mquerostudio/OpenNAS/1-CAD/HDD_Panel.FCStd

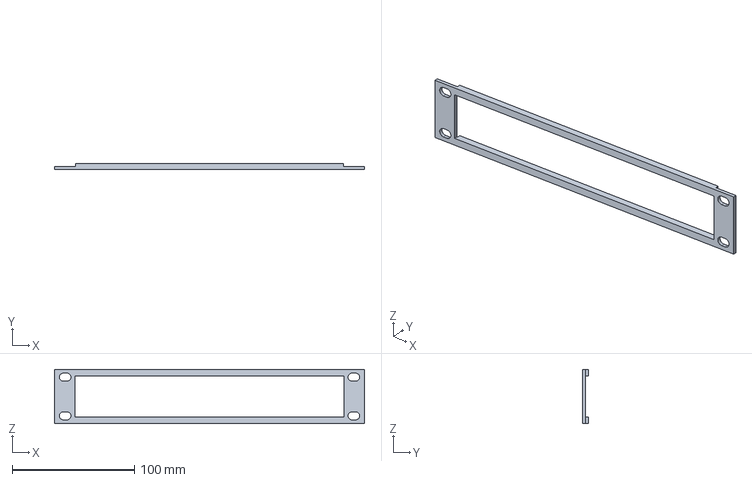
[picture p1: CAD file, 2026-03-18]
1-CAD/HDD_Panel.FCStd
254.0 x 5.00 x 44.2 mm
