mquerostudio/OpenNAS/1-CAD/Modular 10 Server/Base/Feet Right.step

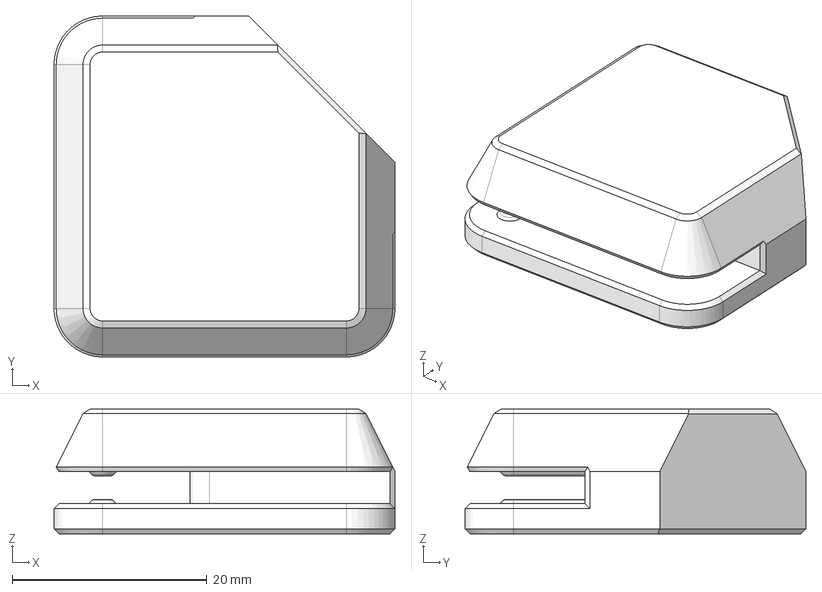
[picture p2: CAD file, 2025-12-29]
1-CAD/Modular 10 Server/Base/Feet Right.step
35.0 x 35.0 x 12.8 mm
