mquerostudio/OpenNAS/1-CAD/Modular 10 Server/Cover/Cover Plate Holes.step

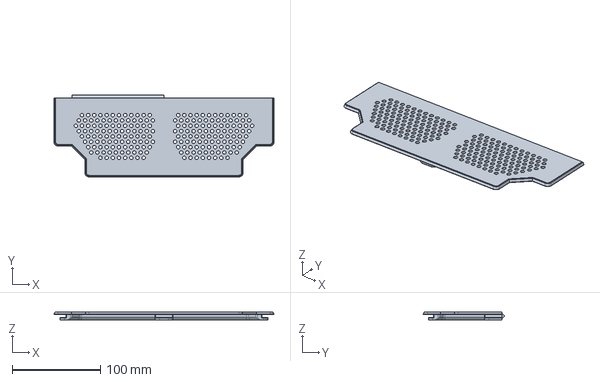
[picture p3: CAD file, 2025-12-29]
1-CAD/Modular 10 Server/Cover/Cover Plate Holes.step
249.6 x 92.8 x 9.60 mm
