mquerostudio/OpenNAS/1-CAD/Modular 10 Server/Panels/Panels.FCStd

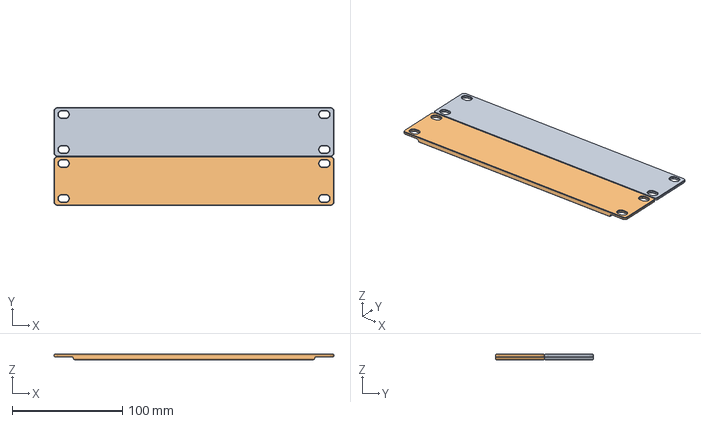
[picture p4: CAD file, 2025-12-29]
1-CAD/Modular 10 Server/Panels/Panels.FCStd
254.0 x 88.7 x 5.00 mm
Panel002
Panel001
