mquerostudio/OpenNAS/1-CAD/Modular 10 Server/Shelfs/Shelf 100mm 1U.step

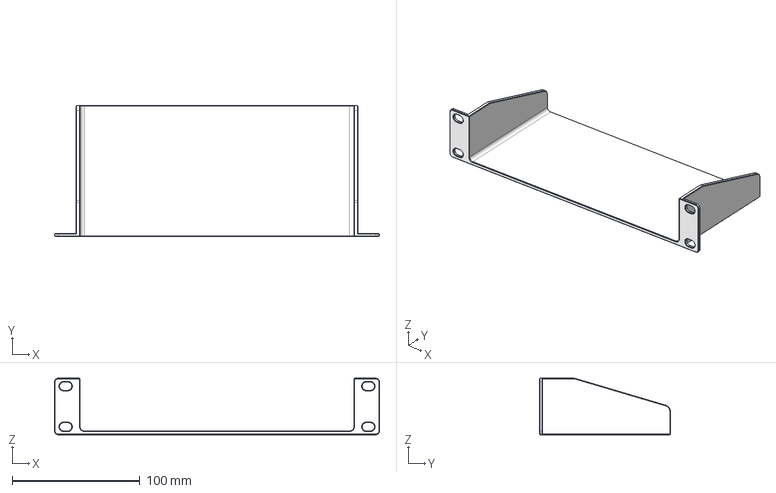
[picture p5: CAD file, 2025-12-29]
1-CAD/Modular 10 Server/Shelfs/Shelf 100mm 1U.step
254.0 x 102.5 x 44.2 mm
