mquerostudio/OpenNAS/1-CAD/Caddy.FCStd

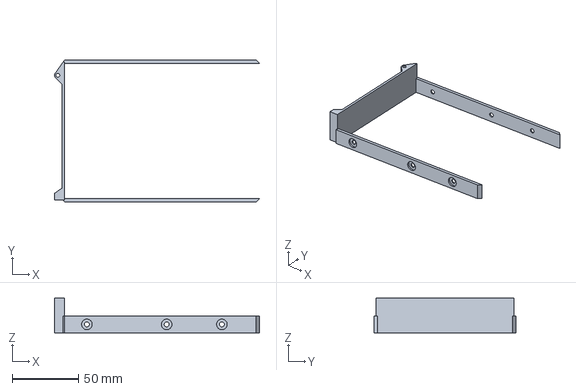
[picture p6: CAD file, 2026-03-18]
1-CAD/Caddy.FCStd
154.3 x 106.8 x 26.1 mm
