mquerostudio/OpenNAS/1-CAD/Modular 10 Server/Cover/Cover Plate Plain.step

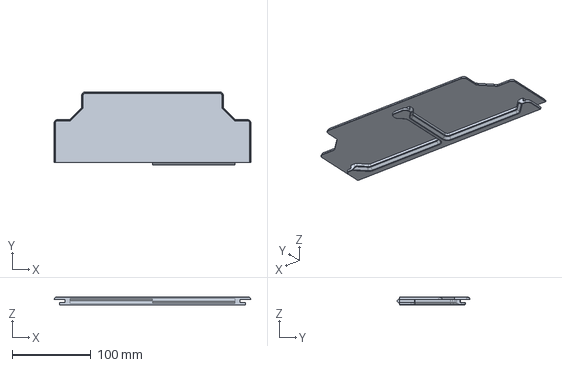
[picture p7: CAD file, 2025-12-29]
1-CAD/Modular 10 Server/Cover/Cover Plate Plain.step
249.6 x 92.8 x 9.60 mm
