mquerostudio/OpenNAS/1-CAD/Modular 10 Server/Panels/Panel 2U.step

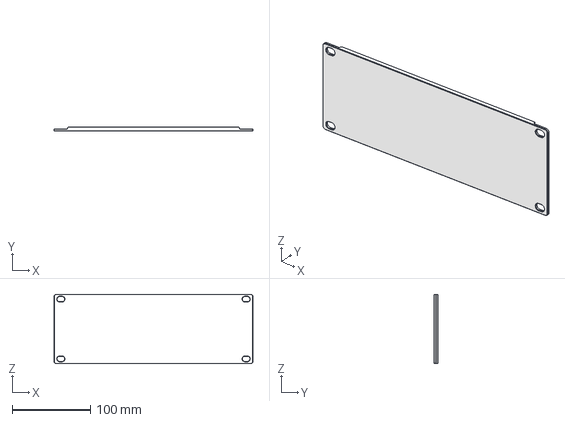
[picture p8: CAD file, 2025-12-29]
1-CAD/Modular 10 Server/Panels/Panel 2U.step
254.0 x 5.00 x 88.7 mm
