mquerostudio/OpenNAS/1-CAD/Modular 10 Server/Shelfs/Shelf 100mm 2U.step

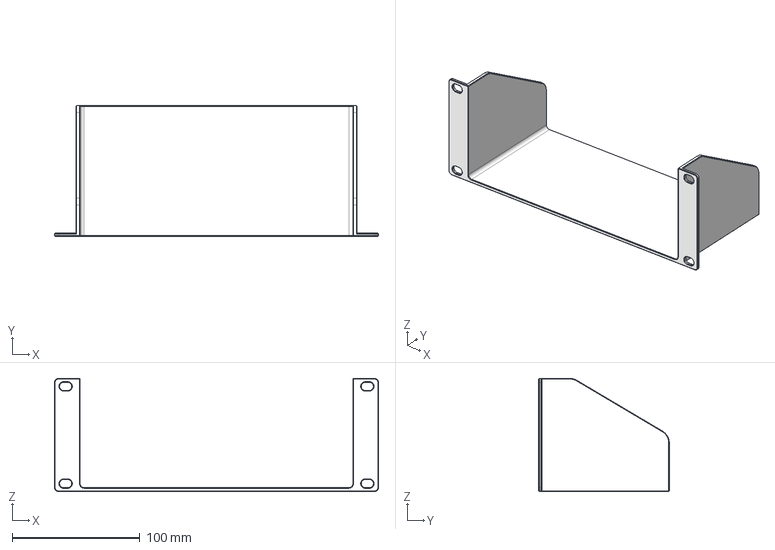
[picture p9: CAD file, 2025-12-29]
1-CAD/Modular 10 Server/Shelfs/Shelf 100mm 2U.step
254.0 x 102.5 x 88.7 mm
