mquerostudio/OpenNAS/1-CAD/Modular 10 Server/Base/Bracket Left.step

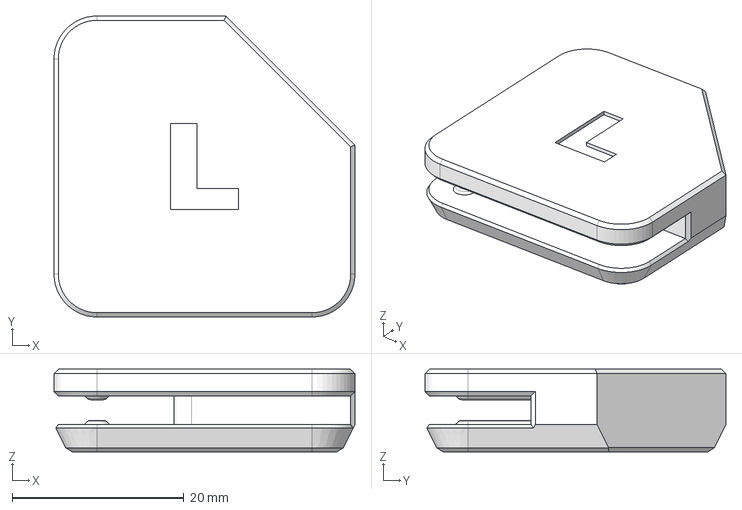
[picture p10: CAD file, 2025-12-29]
1-CAD/Modular 10 Server/Base/Bracket Left.step
35.0 x 35.0 x 9.60 mm
