mquerostudio/OpenNAS/1-CAD/Modular 10 Server/Panels/Panel 1U.step

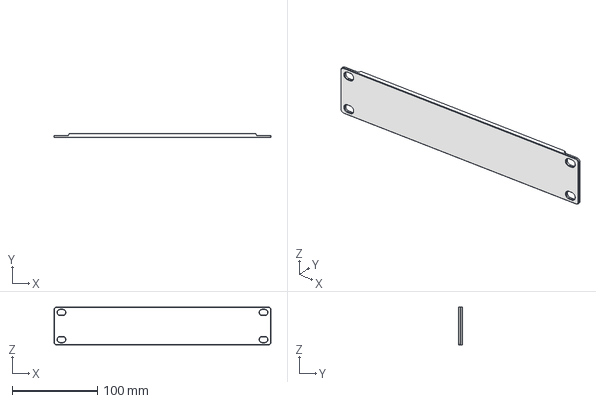
[picture p11: CAD file, 2025-12-29]
1-CAD/Modular 10 Server/Panels/Panel 1U.step
254.0 x 5.00 x 44.3 mm
