mquerostudio/OpenNAS/1-CAD/NAS_Panel-NASBody.stl

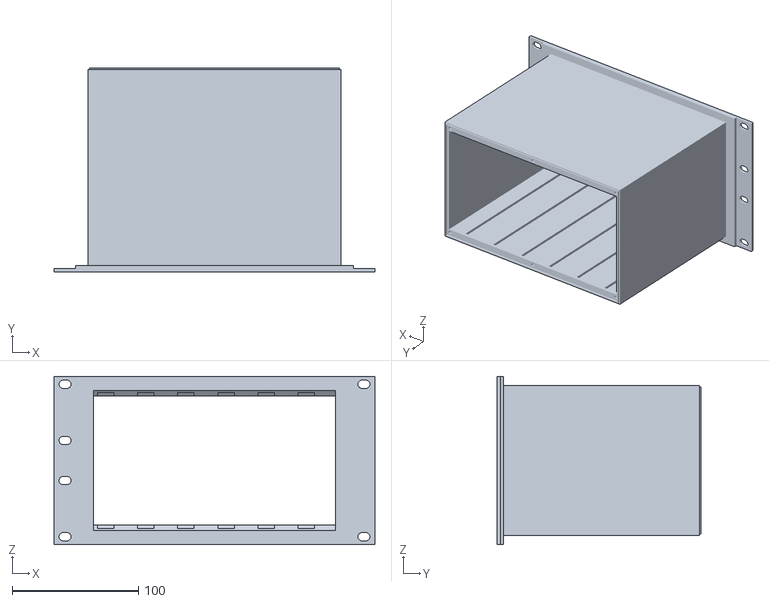
[picture p12: CAD file, 2026-03-18]
1-CAD/NAS_Panel-NASBody.stl
254.0 x 161.2 x 133.1
