mquerostudio/OpenNAS/1-CAD/Modular 10 Server/Base/Cross Panel.step

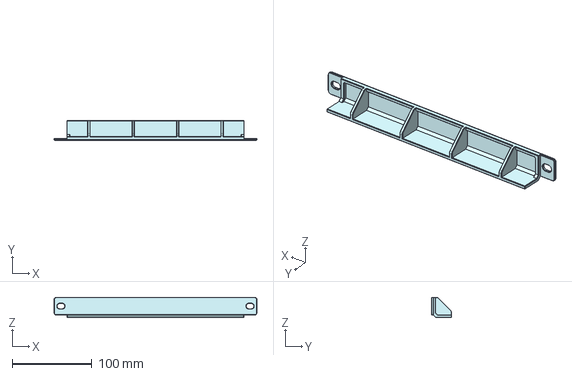
[picture p13: CAD file, 2025-12-29]
1-CAD/Modular 10 Server/Base/Cross Panel.step
254.0 x 24.7 x 25.3 mm
