mquerostudio/OpenNAS/1-CAD/Server.FCStd

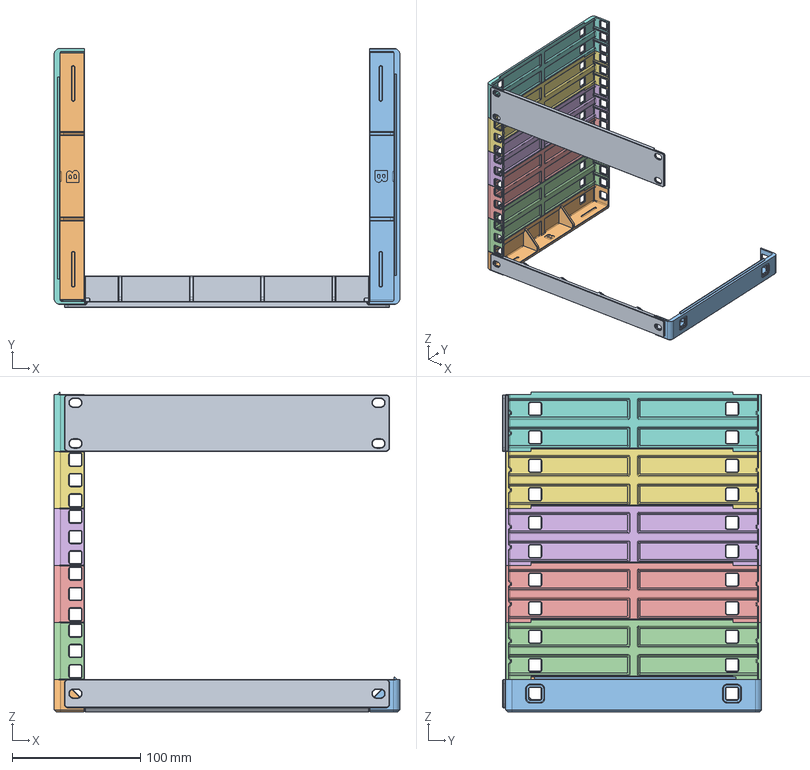
[picture p14: CAD file, 2026-03-18]
1-CAD/Server.FCStd
270.0 x 202.5 x 249.7 mm
Cross Panel
BottomL
BottomR
SideL1
SideL2
SideL3
SideL4
SideL5
Panel
