mquerostudio/OpenNAS/1-CAD/Modular 10 Server/Base/Side 1U.step

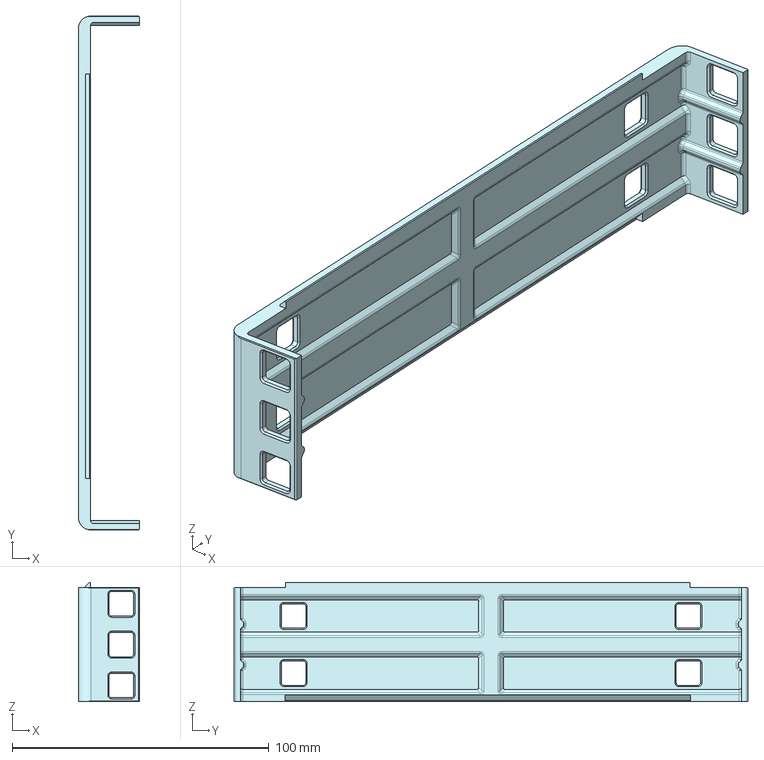
[picture p15: CAD file, 2025-12-29]
1-CAD/Modular 10 Server/Base/Side 1U.step
23.9 x 200.0 x 46.5 mm
