mquerostudio/OpenNAS/1-CAD/NAS_Panel-NASSketch009.dxf

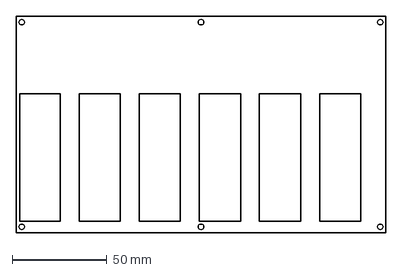
[picture p16: CAD file, 2026-03-18]
1-CAD/NAS_Panel-NASSketch009.dxf
195.5 x 114.3 mm
