mquerostudio/OpenNAS/1-CAD/Modular 10 Server/Base/Connector Cross Panel.step

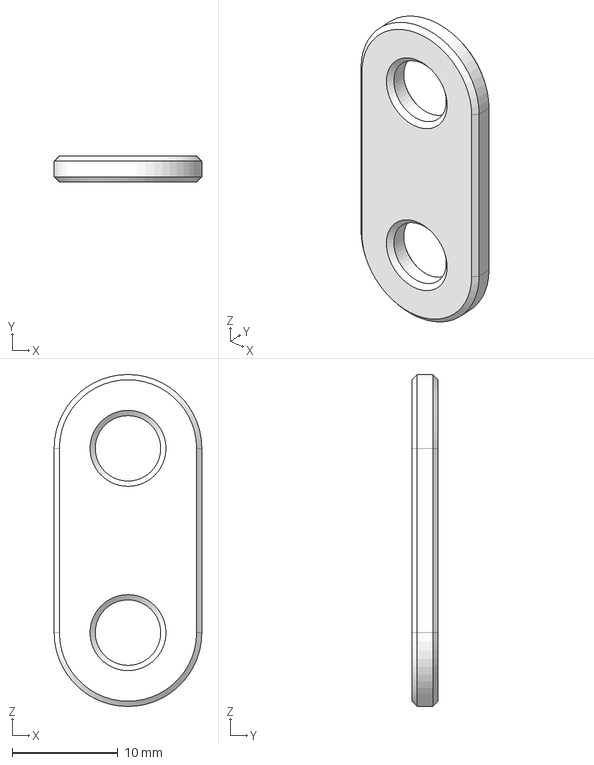
[picture p17: CAD file, 2025-12-29]
1-CAD/Modular 10 Server/Base/Connector Cross Panel.step
14.0 x 2.50 x 31.5 mm
