mquerostudio/OpenNAS/1-CAD/NAS_Panel-NASPCBA.dxf

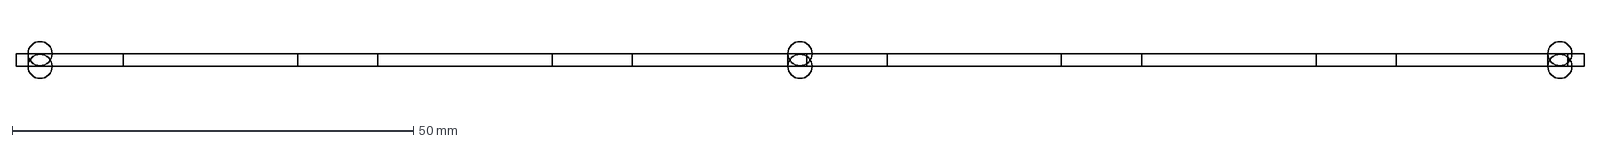
[picture p18: CAD file, 2026-03-18]
1-CAD/NAS_Panel-NASPCBA.dxf
195.5 x 4.60 mm
