mquerostudio/OpenNAS/1-CAD/Caddy-CaddyLid.stl

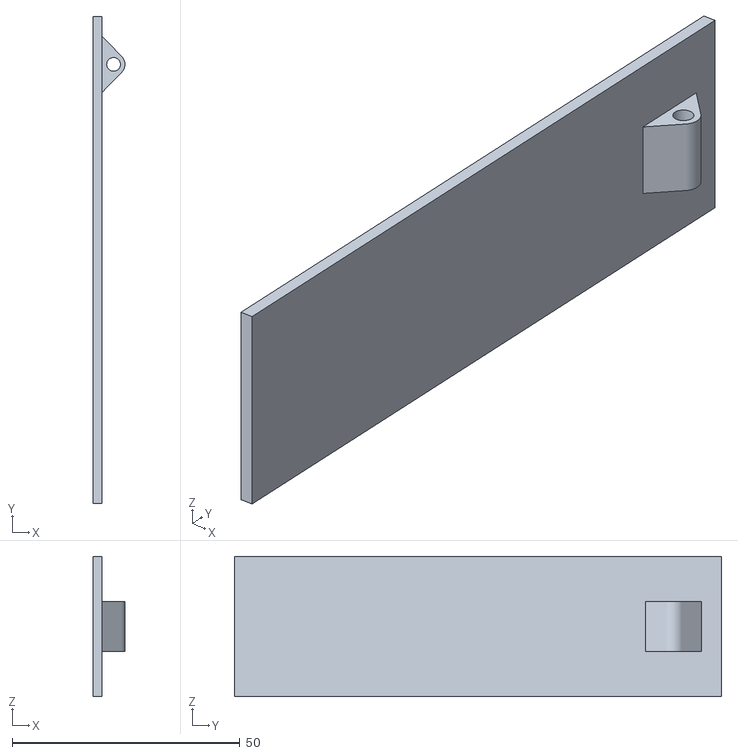
[picture p19: CAD file, 2026-03-18]
1-CAD/Caddy-CaddyLid.stl
7.00 x 106.8 x 30.8
