mquerostudio/OpenNAS/1-CAD/Modular 10 Server/Base/Connector Panel.step

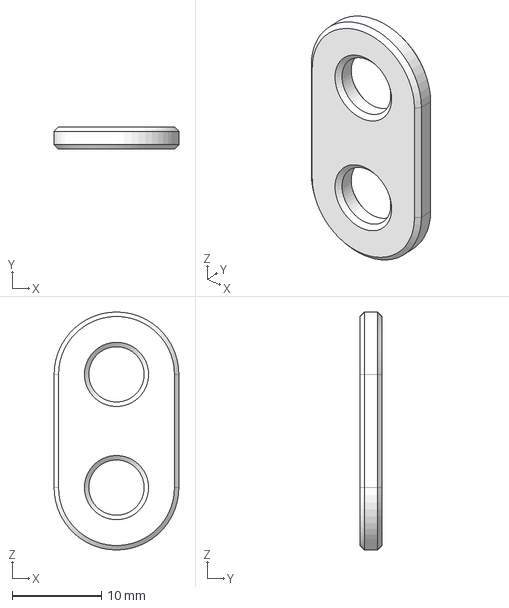
[picture p20: CAD file, 2025-12-29]
1-CAD/Modular 10 Server/Base/Connector Panel.step
14.0 x 2.50 x 26.7 mm
