mquerostudio/OpenNAS/1-CAD/HDD_IronWolf.FCStd

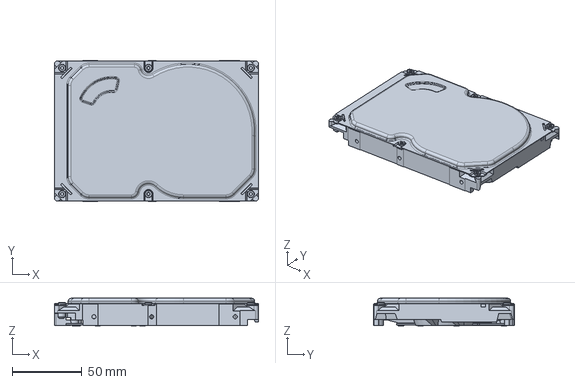
[picture p21: CAD file, 2026-03-18]
1-CAD/HDD_IronWolf.FCStd
146.5 x 101.5 x 19.8 mm
