mquerostudio/OpenNAS/1-CAD/Modular 10 Server/Base/Connector.step

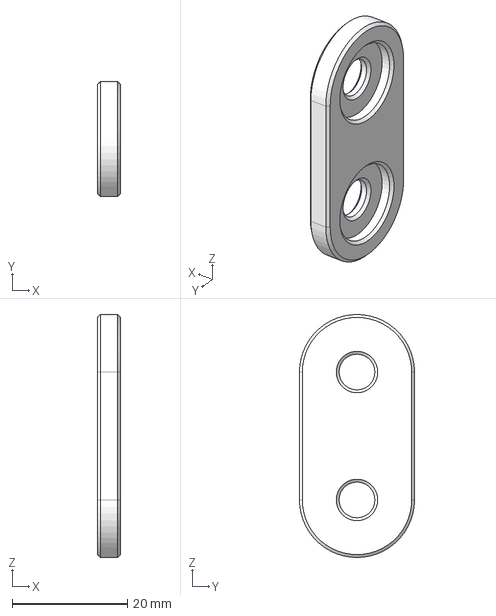
[picture p22: CAD file, 2025-12-29]
1-CAD/Modular 10 Server/Base/Connector.step
4.00 x 20.0 x 42.2 mm
