mquerostudio/OpenNAS/1-CAD/NAS_Panel.FCStd

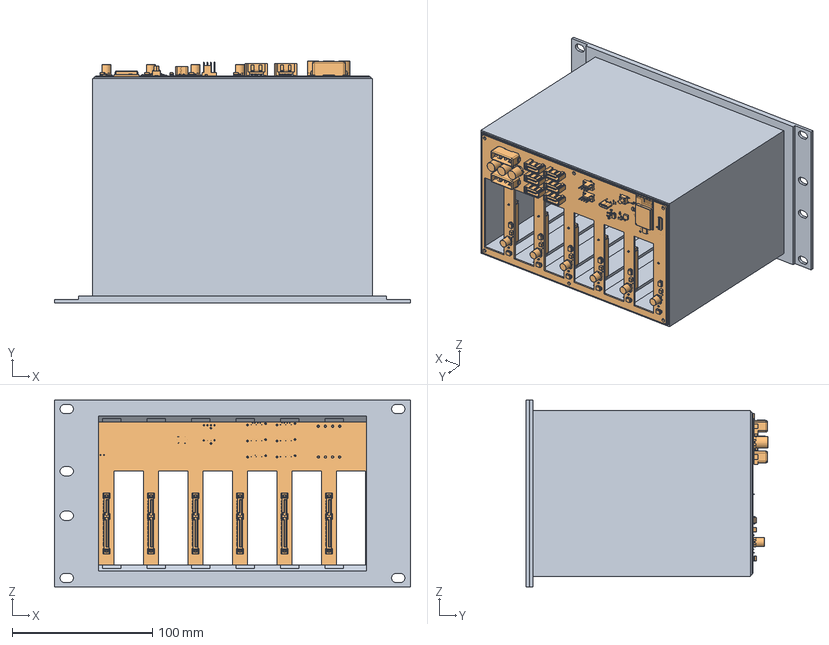
[picture p23: CAD file, 2026-03-18]
1-CAD/NAS_Panel.FCStd
254.0 x 172.5 x 133.2 mm
OpenNAS
