mquerostudio/OpenNAS/1-CAD/Modular 10 Server/Base/Bottom.step

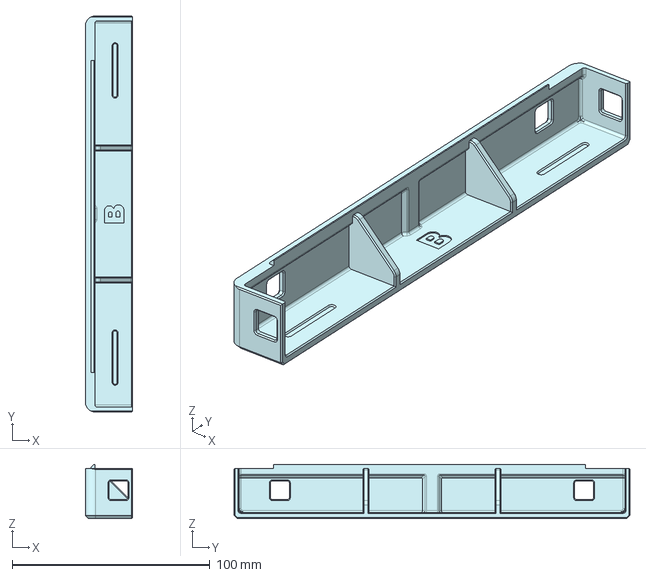
[picture p24: CAD file, 2025-12-29]
1-CAD/Modular 10 Server/Base/Bottom.step
23.9 x 200.0 x 27.4 mm
