mquerostudio/OpenNAS/1-CAD/Modular 10 Server/Base/Top.step

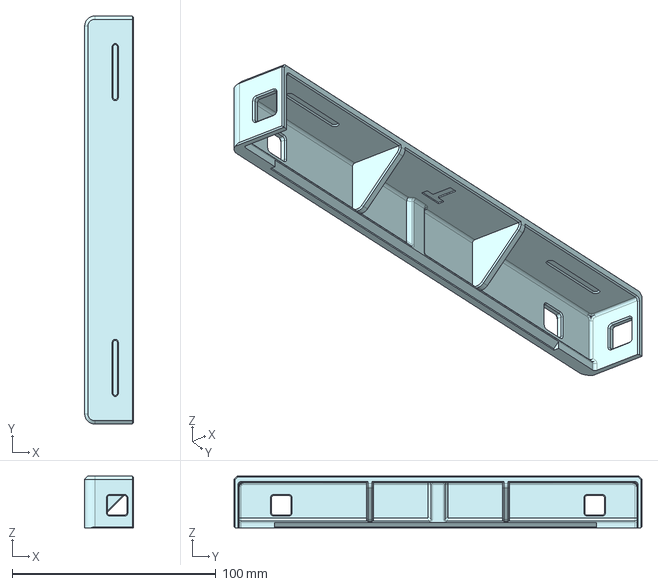
[picture p25: CAD file, 2025-12-29]
1-CAD/Modular 10 Server/Base/Top.step
23.9 x 200.0 x 25.4 mm
