mquerostudio/OpenNAS/1-CAD/2.5'' SATA SSD.stp

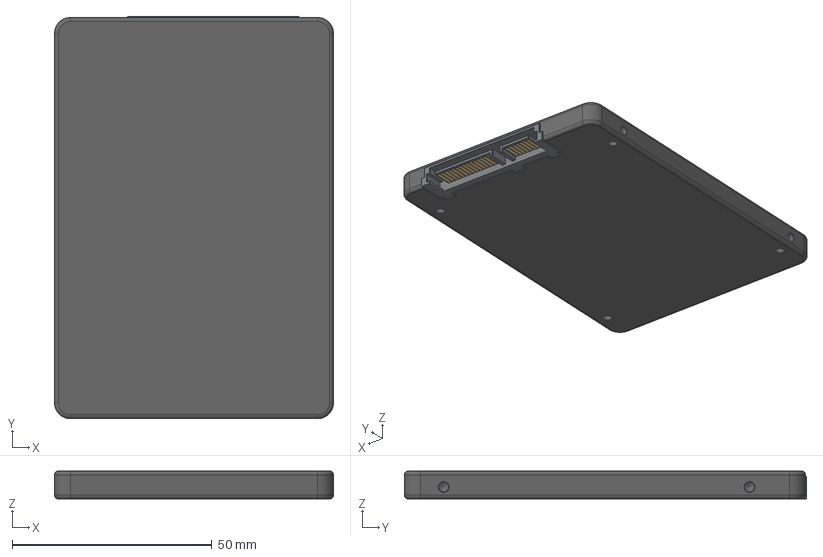
[picture p26: CAD file, 2025-12-29]
1-CAD/2.5'' SATA SSD.stp
69.9 x 100.8 x 7.00 mm
