mquerostudio/OpenNAS/1-CAD/Modular 10 Server/Base/Feet Template.step

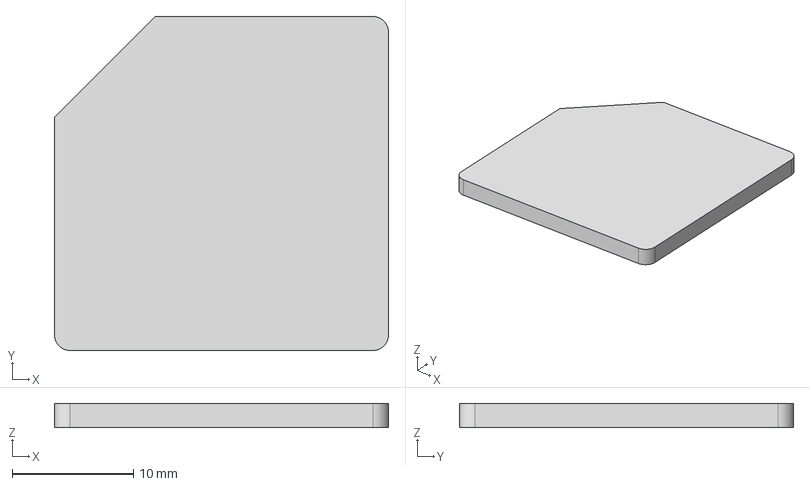
[picture p27: CAD file, 2025-12-29]
1-CAD/Modular 10 Server/Base/Feet Template.step
27.6 x 27.6 x 2.00 mm
