mquerostudio/OpenNAS/1-CAD/Modular 10 Server/Base/Side 2U.step

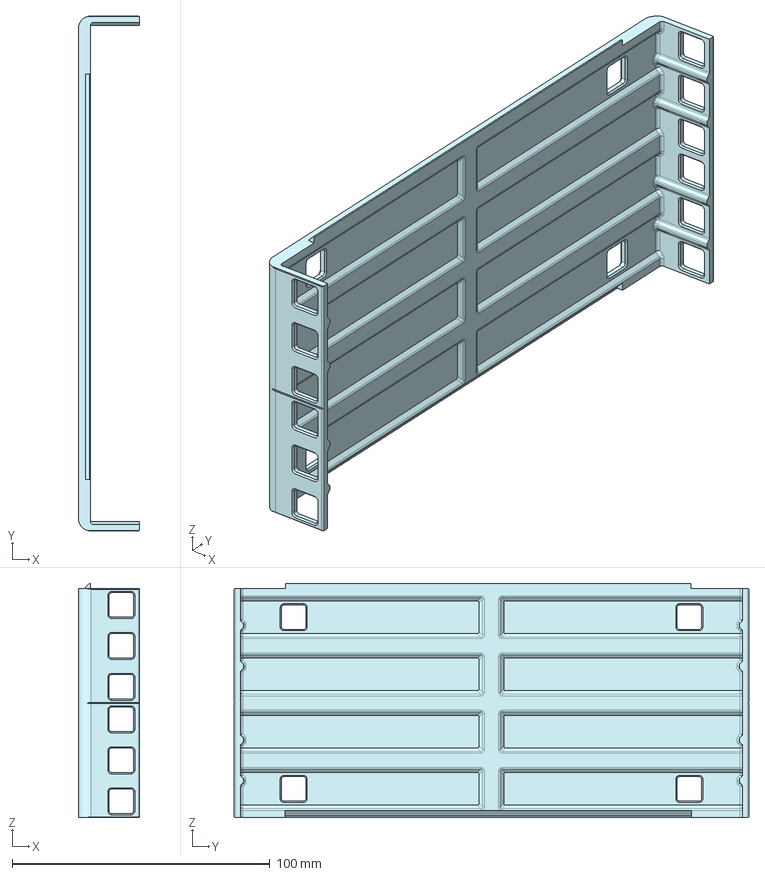
[picture p28: CAD file, 2025-12-29]
1-CAD/Modular 10 Server/Base/Side 2U.step
23.9 x 200.0 x 90.9 mm
