mquerostudio/OpenNAS/1-CAD/NF-A8.STEP

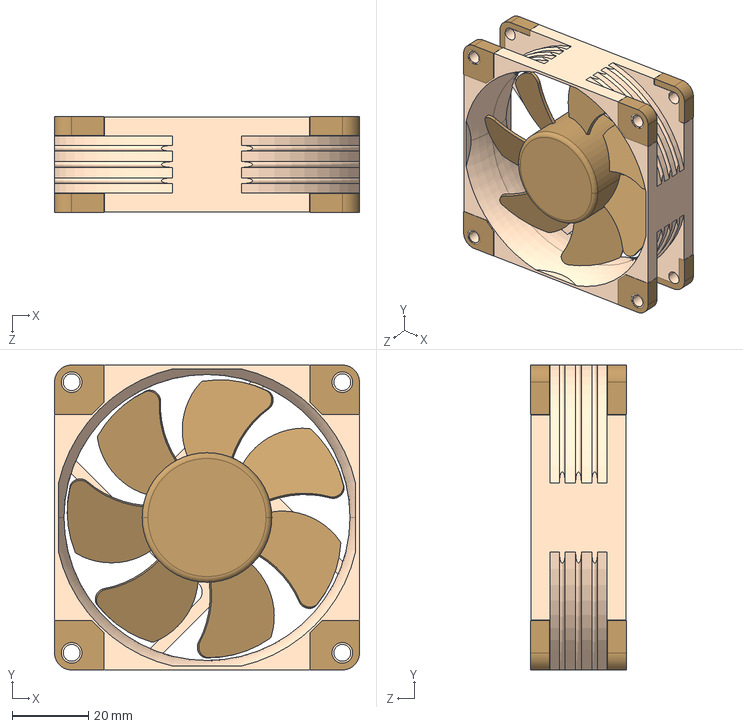
[picture p29: CAD file, 2025-12-29]
1-CAD/NF-A8.STEP
80.0 x 80.0 x 25.2 mm
