mquerostudio/OpenNAS/1-CAD/AS1166 PCIex sata x4  6 ports.step

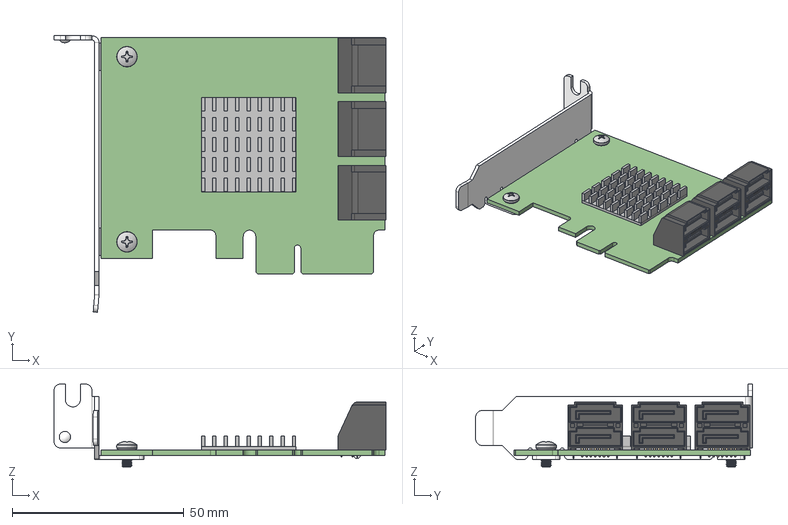
[picture p30: CAD file, 2025-12-29]
1-CAD/AS1166 PCIex sata x4 6 ports.step
96.6 x 80.5 x 24.1 mm
PCIe_x4_LowProfile
92000A114_Passivated 18-8 Stainless Steel Pan Head Phillips Screws x 2
Adam Tech Dual Sata x 3
HeatSink
PCIe Brakets_PCIE card IO panel lowprofil
