mquerostudio/OpenNAS/(list of files, cad)

Other CAD files:
1-CAD/Modular 10 Server/Base/Feet Left.step
1-CAD/Modular 10 Server/Base/Bracket Right.step
1-CAD/Caddy-CaddyBody.stl
1-CAD/NAS_Panel-ServerBody.stl
1-CAD/NAS_Panel-NASBody.dxf
1-CAD/NF-A8.FCStd
