mquerostudio/OpenNAS/3-Firmware/OpenNASFW/docs/OpenNAS_SCH.pdf

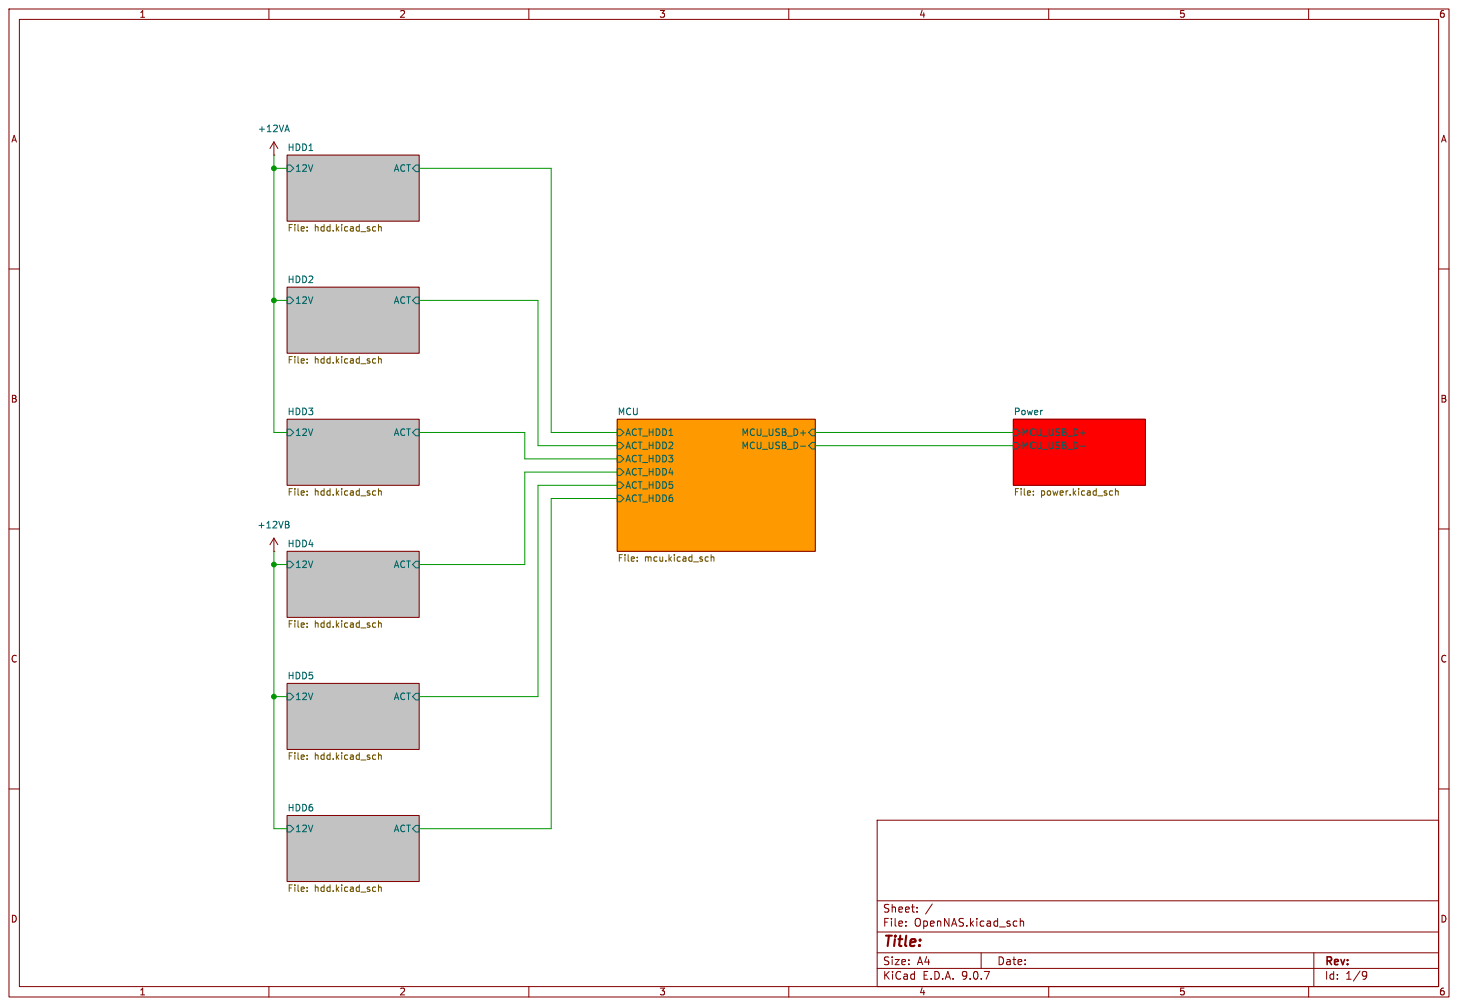
[picture p31: page 1]

Id: 1/9 Title: File: OpenNAS.kicad_sch Sheet: /

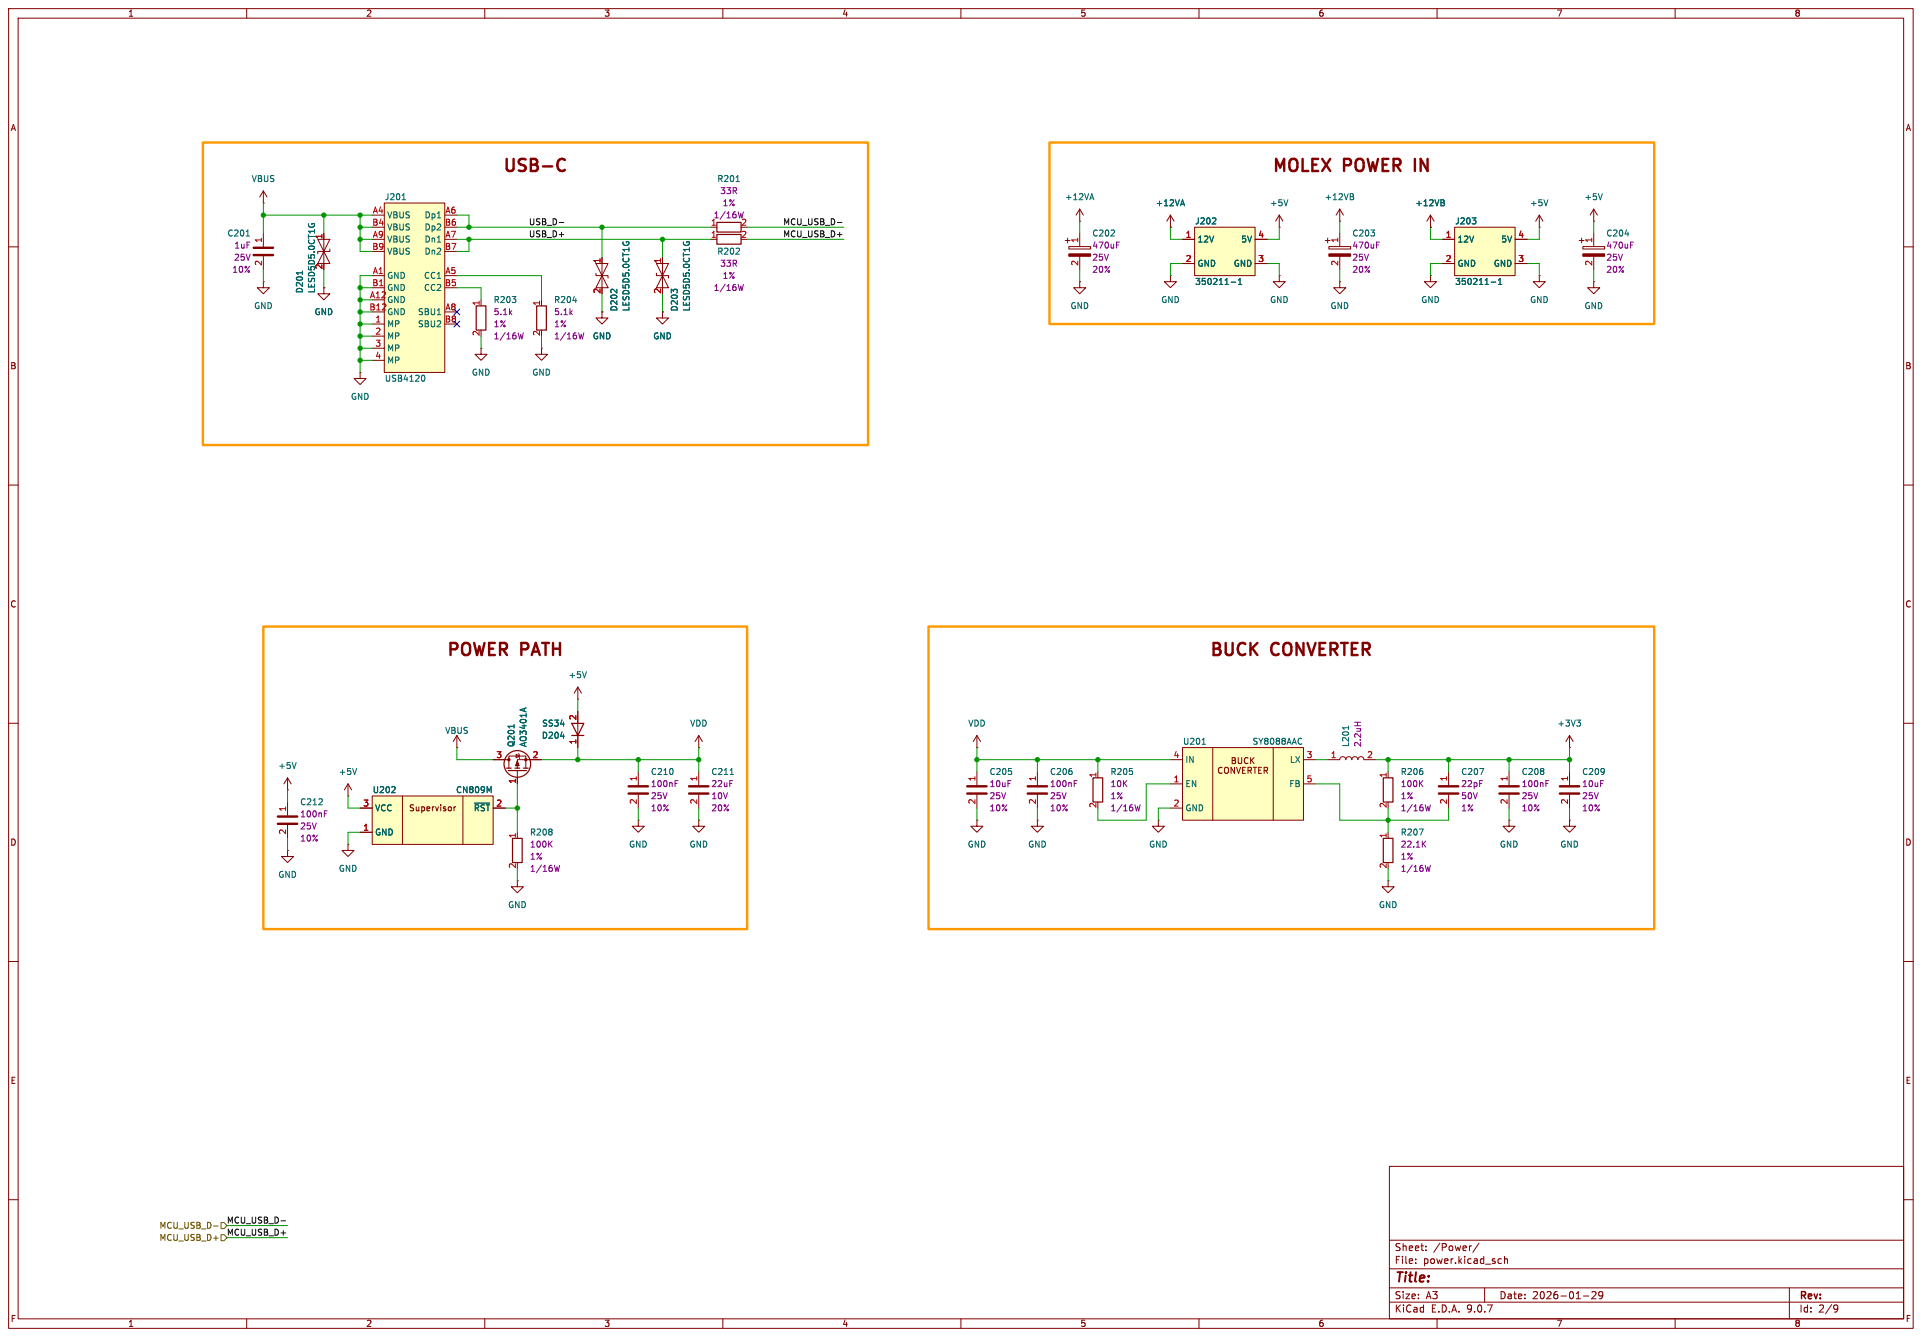
[picture p32: page 2]

Id: 2/9 Title: File: power.kicad_sch Sheet: /Power/

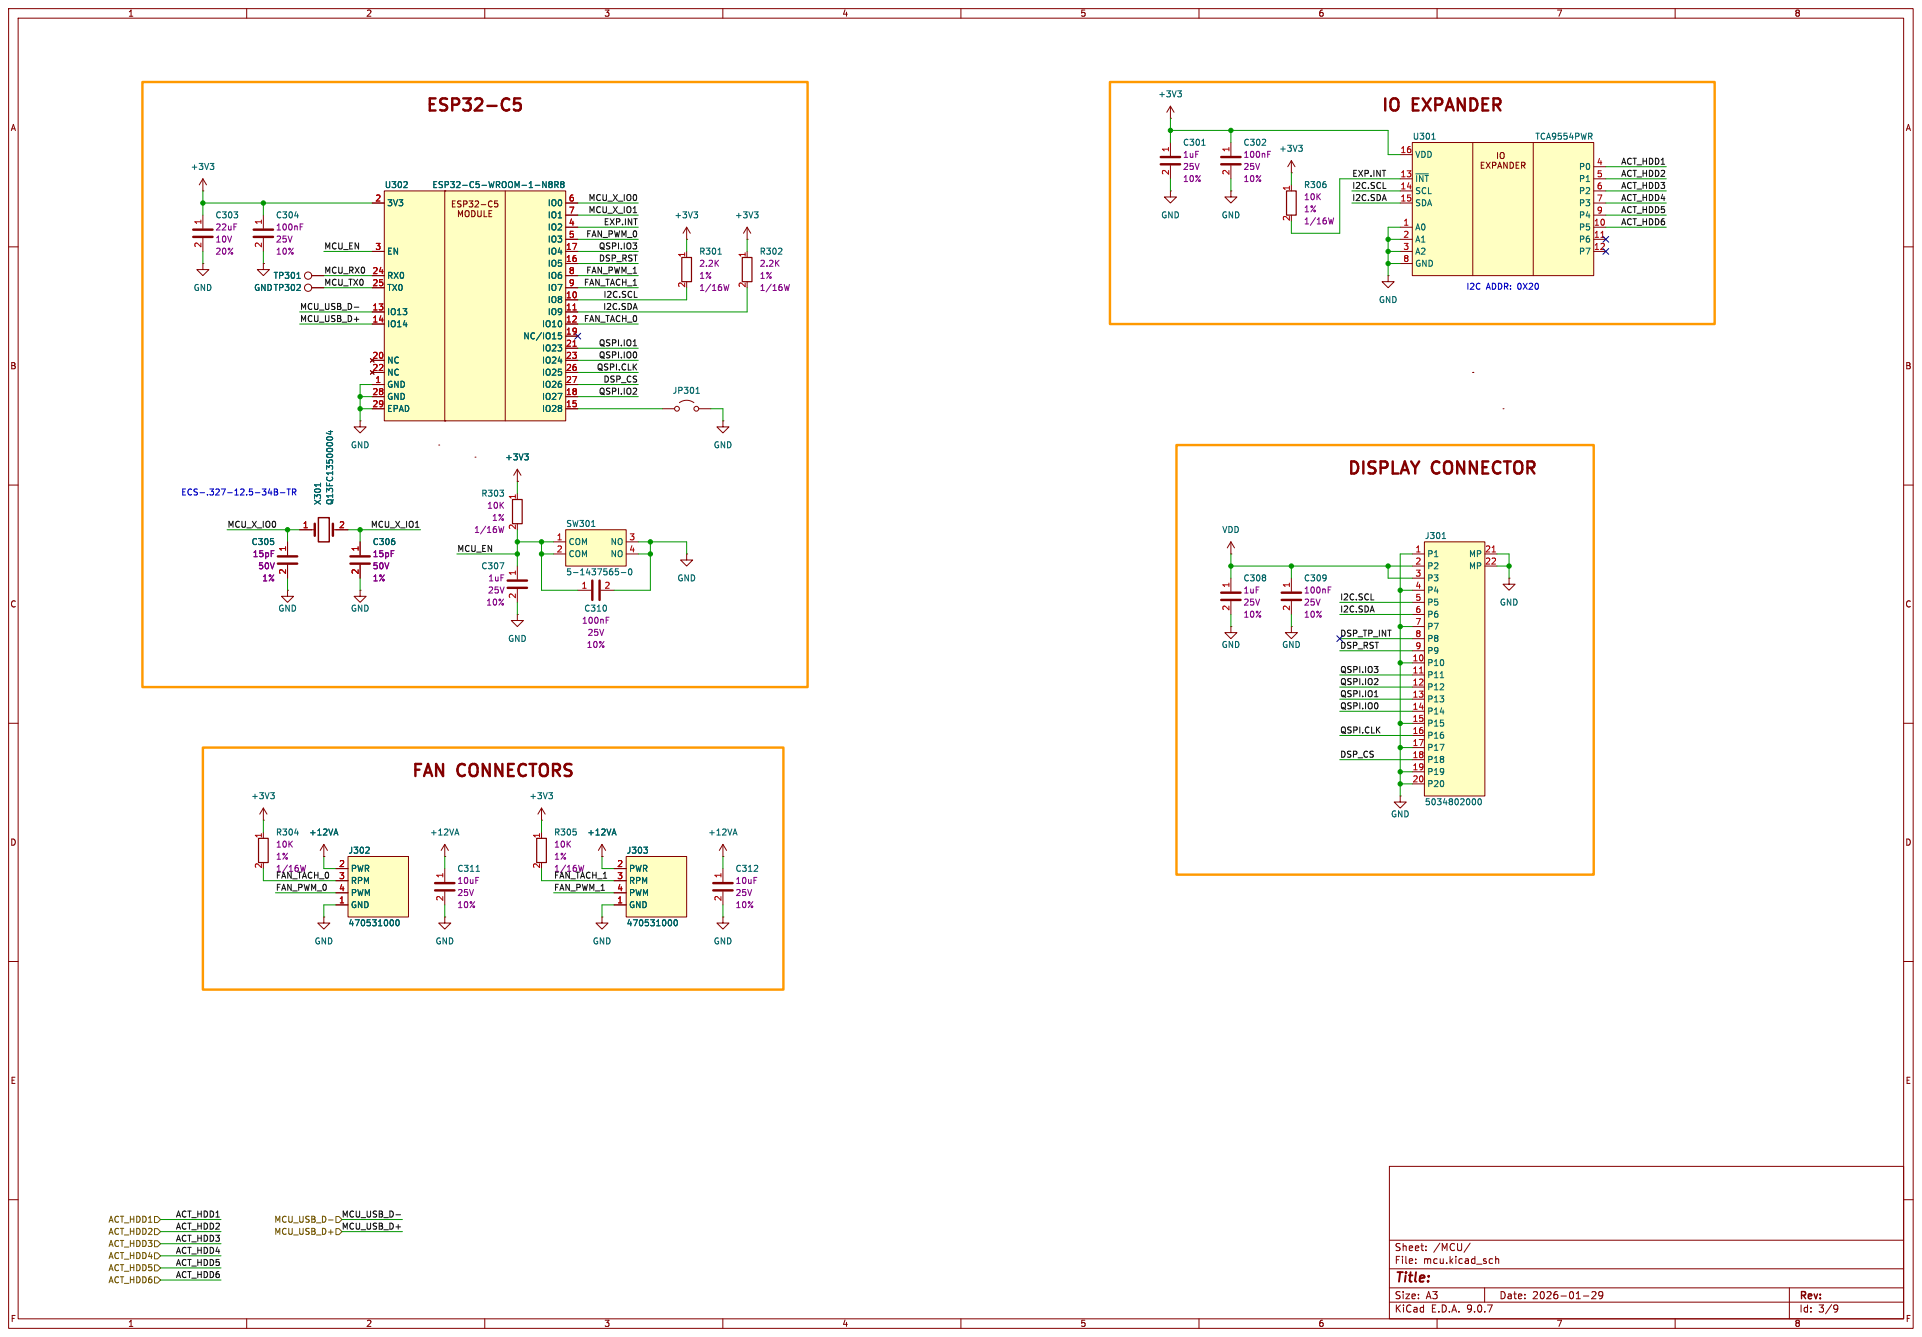
[picture p33: page 3]

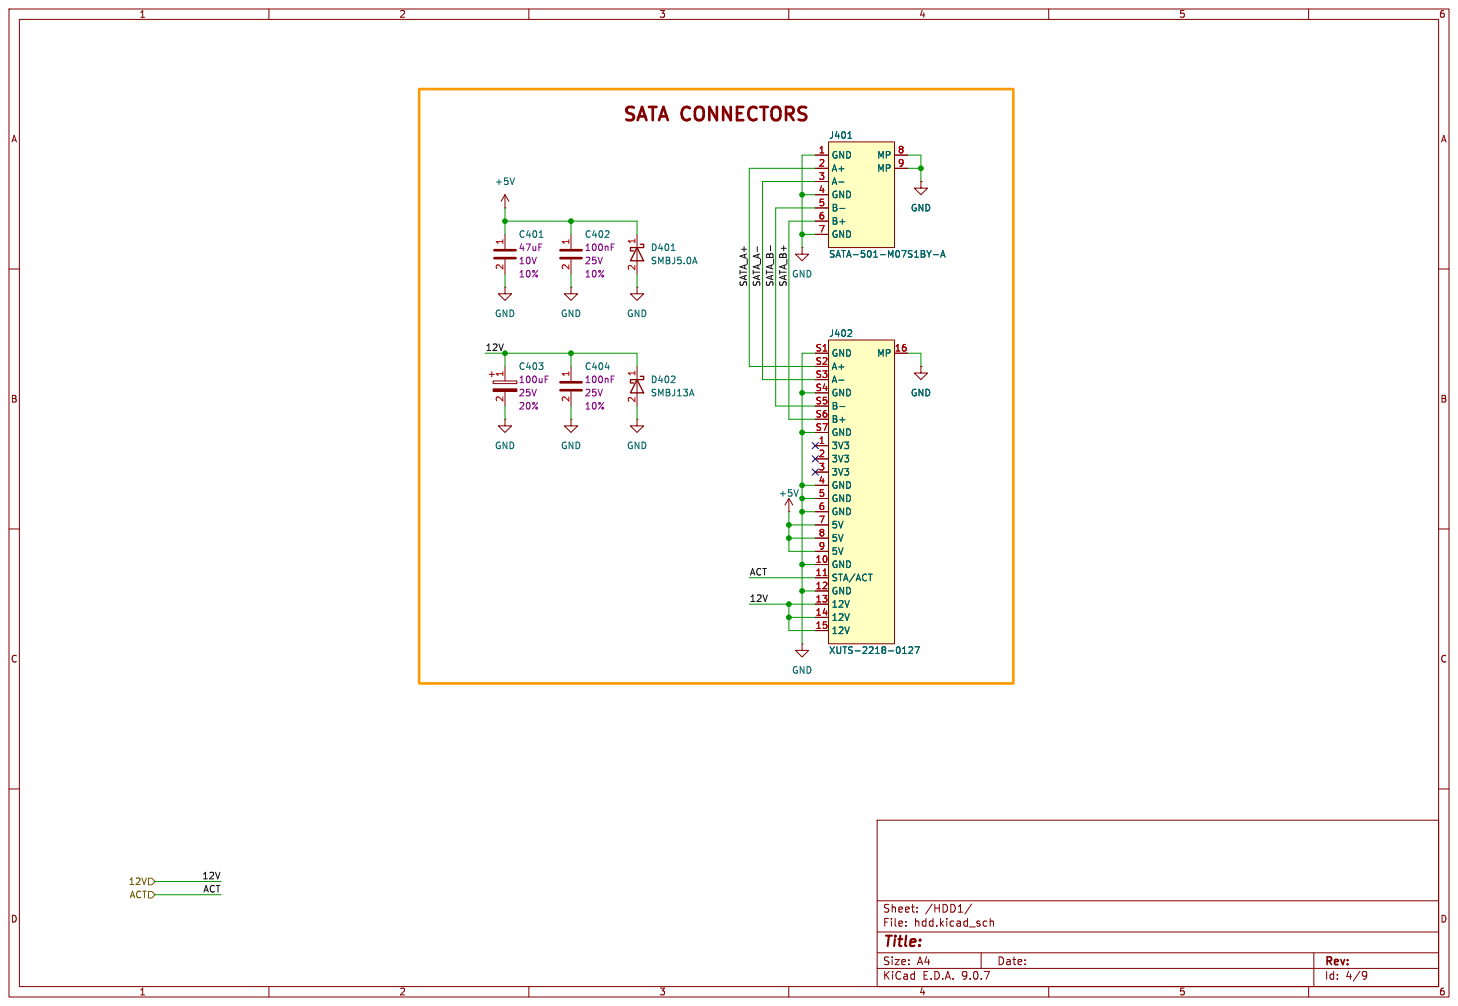
[picture p34: page 4]

Id: 4/9 Title: File: hdd.kicad_sch Sheet: /HDD1/

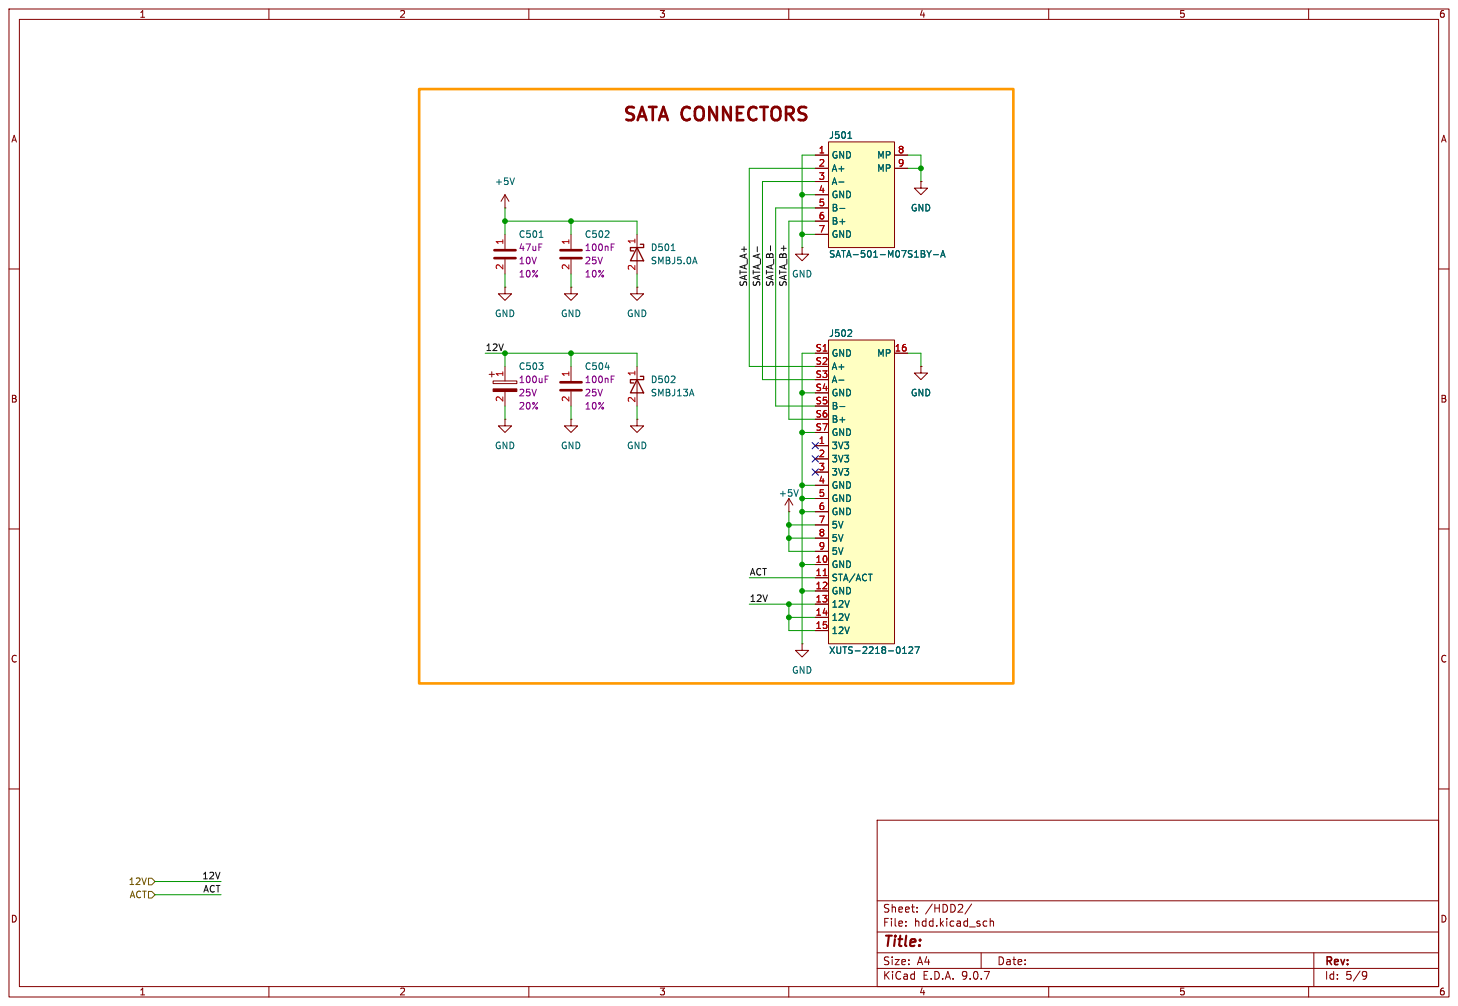
[picture p35: page 5]

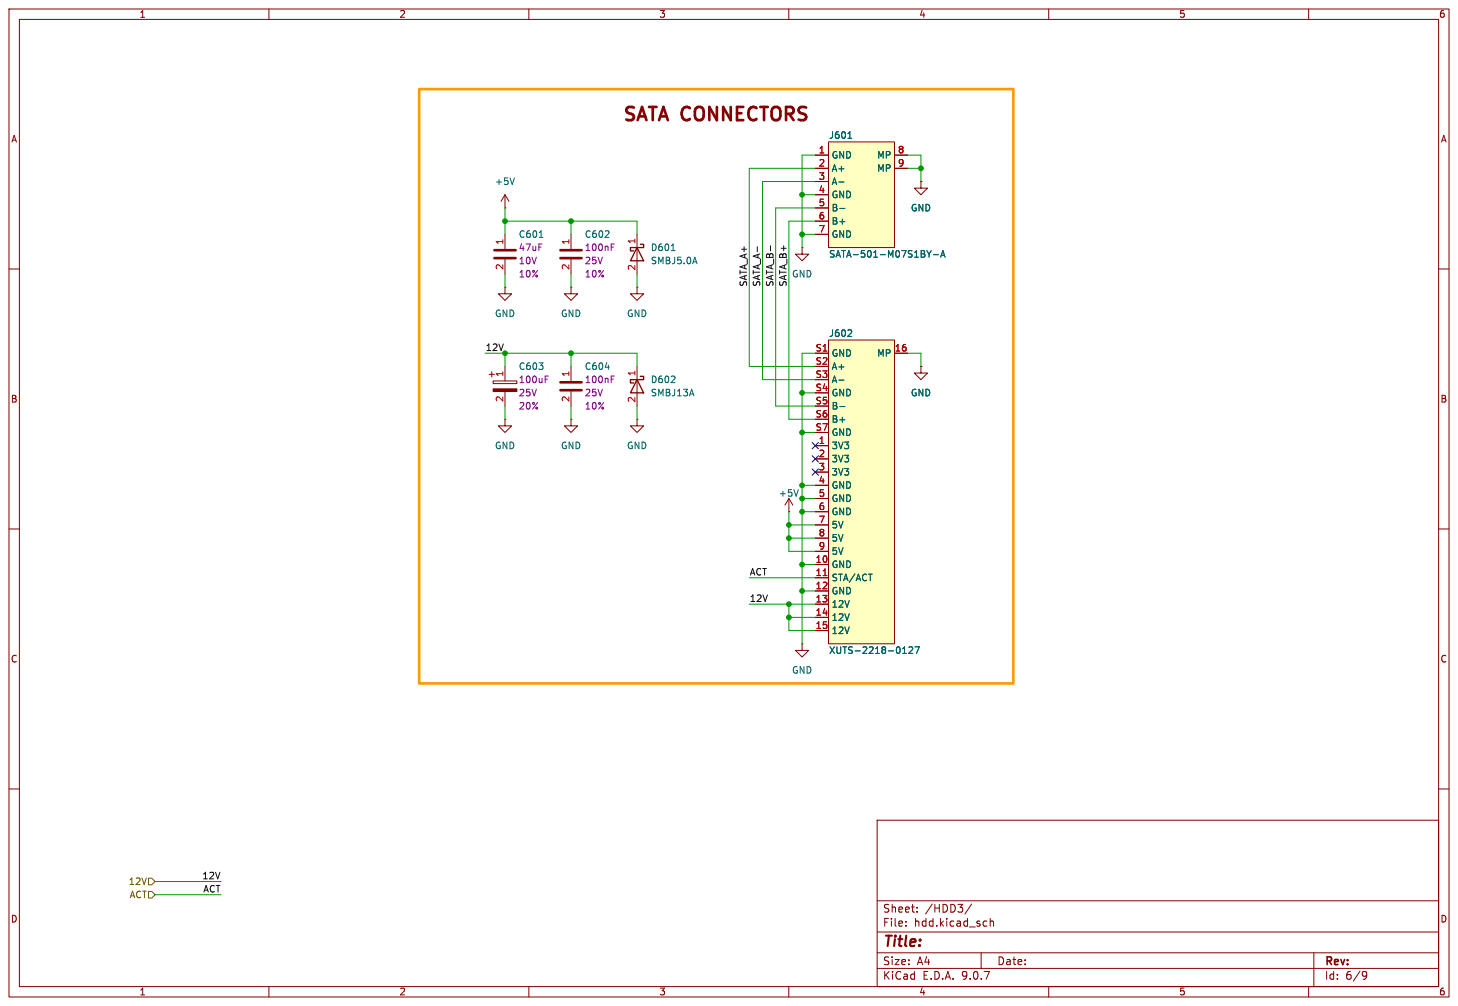
[picture p36: page 6]

Id: 6/9 Title: File: hdd.kicad_sch Sheet: /HDD3/

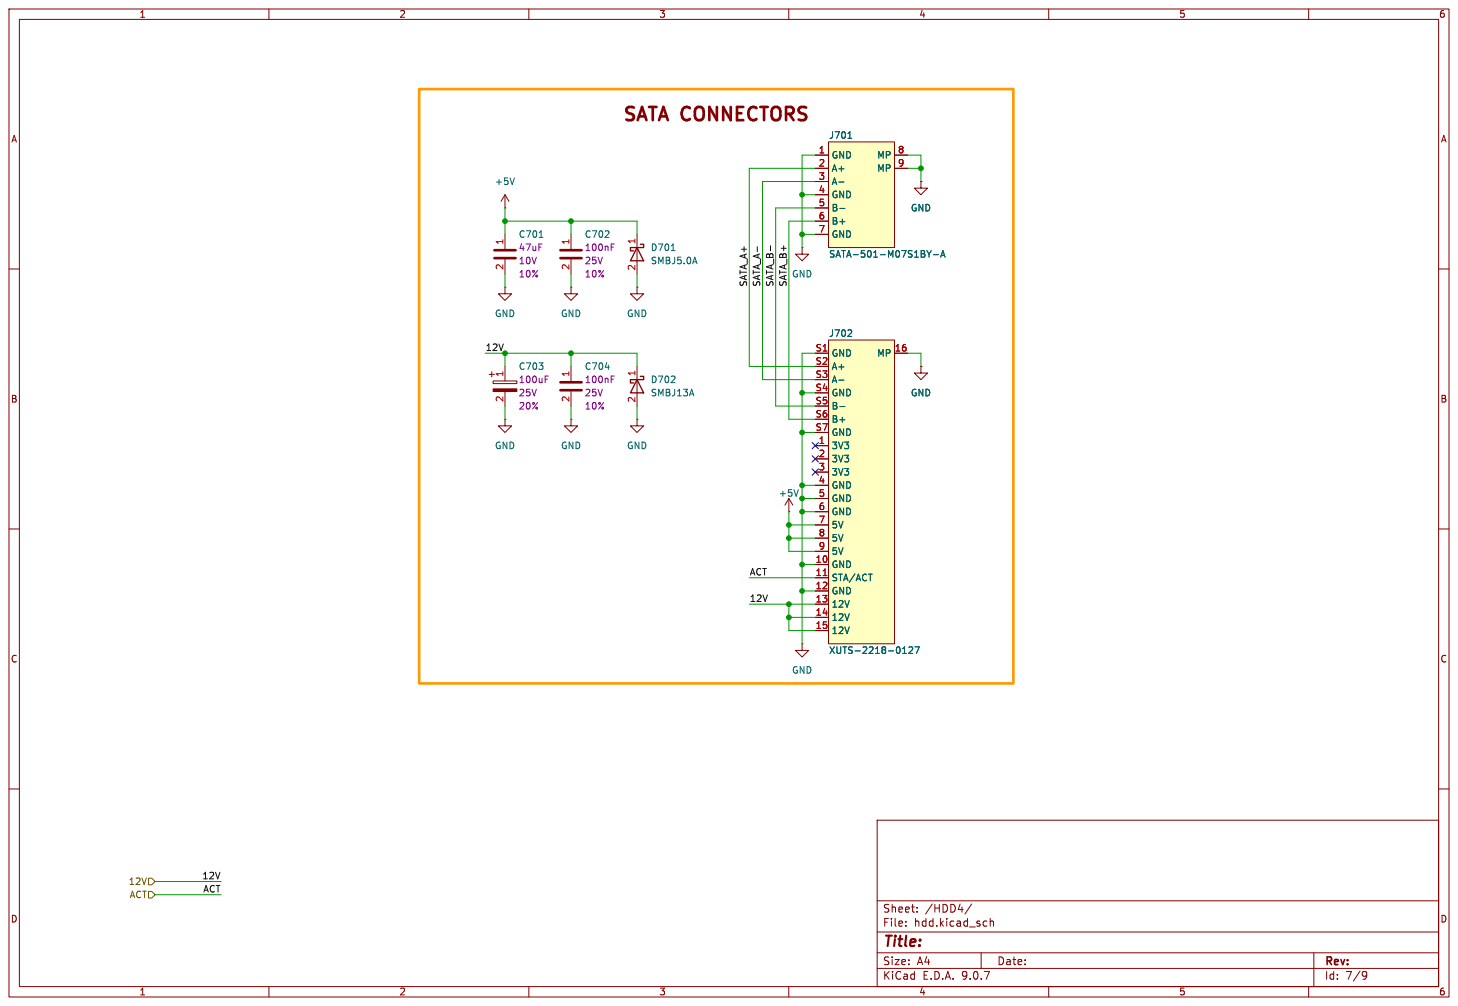
[picture p37: page 7]

Id: 7/9 Title: File: hdd.kicad_sch Sheet: /HDD4/

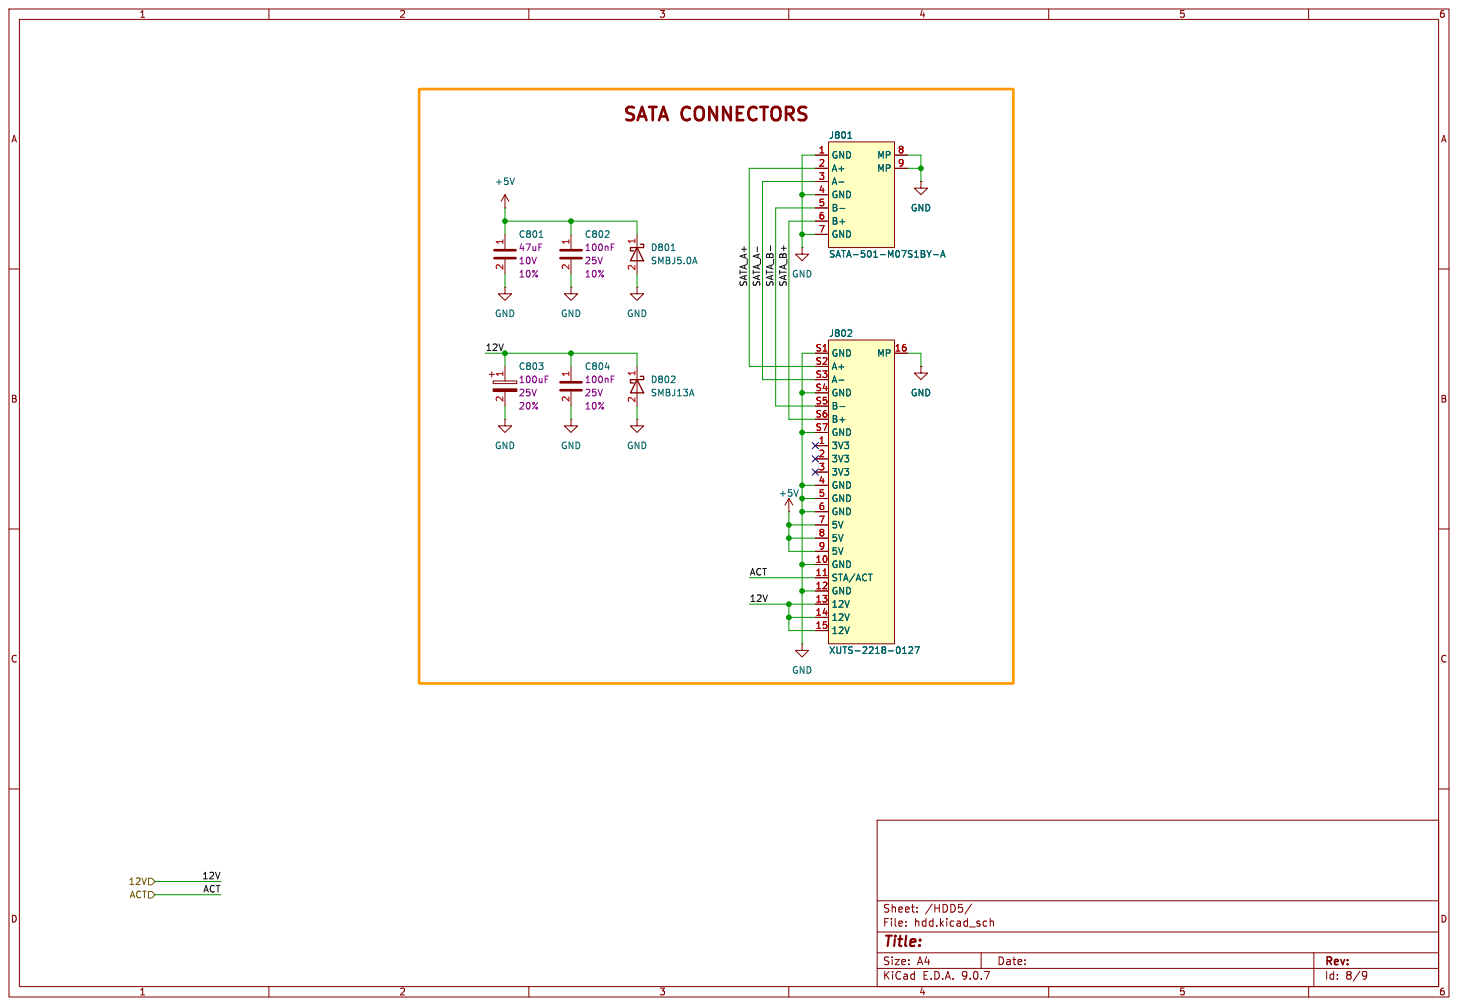
[picture p38: page 8]

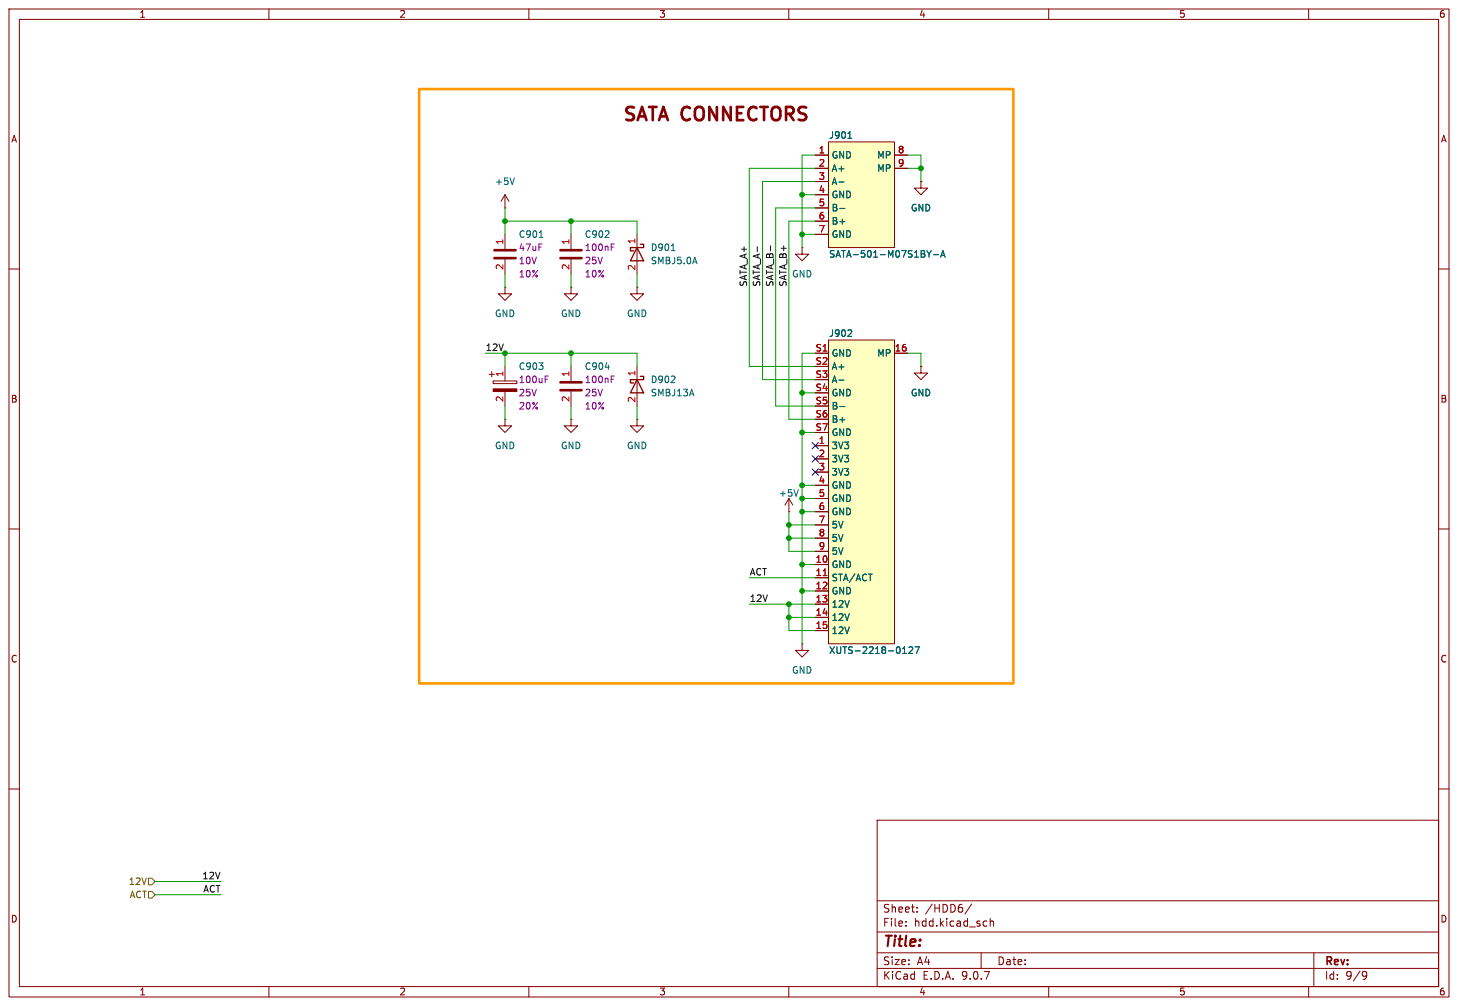
[picture p39: page 9]

Id: 9/9 Title: File: hdd.kicad_sch Sheet: /HDD6/
