mquerostudio/OpenNAS/(commit log)

2025-12-30 new structure
    [2.5'' SATA SSD.stp, AS1166 PCIex sata x4 6 ports.step, Bottom.step, Bracket Left.step, Bracket Right.step, Caddy.FCStd, ComponentDB.ods, Connector Cross Panel.step]
2025-12-30 power and esp32
    [ComponentDB.ods, OpenNAS.kicad_sch]
2025-12-31 power done
    [ComponentDB.ods, OpenNAS.kicad_sch, hdd.kicad_sch, mcu.kicad_sch, power.kicad_sch]
2026-03-18 production version
    [Caddy-CaddyBody.stl, Caddy-CaddyLid.stl, Caddy.FCStd, ComponentDB.ods, HDD_IronWolf.FCStd, HDD_Panel.FCStd, NAS_Panel-NASBody.dxf, NAS_Panel-NASBody.stl]
2026-06-08 docs(fw): spec failsafe + auth del firmware (ESP32 como esclavo seguro)
    El cerebro de la curva de ventiladores vivirá en lab01/cockpit; este spec
    endurece el esclavo: watchdog 100%/60s, sin desgaste de flash (quita NVS por
    comando), auth por token en los POST, estado de failsafe en /api/status.
2026-06-08 docs(fw): plan de implementación failsafe + auth (6 tasks)
2026-06-14 feat(fw): watchdog failsafe + sin persistencia NVS por comando (esclavo)
    [fan_control.c, fan_control.h]
2026-06-14 chore(fw): versionar firmware OpenNAS existente (ESP-IDF, ESP32-C5)
    Firmware base que nunca se habia commiteado: board, fan_control (PWM+tach),
    hdd_monitor (ACT vIa TCA9554), http_server, net_manager (AP/STA), ota_manager,
    provisioning, main. + .gitignore (anade .cache/).
    [partitions.csv]
2026-06-14 docs(fw): README arquitectura+API; fixes review (doc NVS, guard token vacío)
    - README real (esclavo/cerebro, componentes, API, auth, failsafe, build/OTA, token)
    - fan_control.h: comentarios al día (RAM-only, failsafe; ya no 'persiste en NVS')
    - http_auth_ok: fail-closed si el token efectivo está vacío
    [fan_control.h]
2026-06-14 feat(fw): POST /api/set_token + dashboard con auth (token Bearer, set-token, banner failsafe)
    - set_token (auth con token actual): fija auth_token en NVS y lo aplica al
    instante (sin reboot, conserva WiFi). Cambiar el token desde la web.
    - dashboard: campo de token (localStorage) enviado como Bearer en todos los POST
    (arregla fan/reset/OTA que la auth había roto); UI para fijar el token real;
    banner de FAILSAFE; aviso de 401.
2026-06-14 docs(fw): spec rediseño webapp (B: dashboard + cajón) + reboot + set_wifi
    UX del token arreglada (un solo campo), jerarquía clara, botón reiniciar ESP,
    'Cambiar WiFi' (re-home a la red del homelab desde la web) + mac en /api/status.
    Firmware core intacto; solo api_handlers + reescritura del asset. Auth = un token.
    §8: re-homing a 10.10.10.x (reserva DHCP + DNS + ip-plan + cockpit .env) como tarea
    separada del repo homelab.
2026-06-14 docs(fw): README al día — endpoints set_token/set_wifi/reboot, mac, IP homelab (opennas.lab.mquero.com)
